UND-ARC/Nasa-SLI-2024/payload/pcb/SAIL_OBC/SAIL_OBC.png

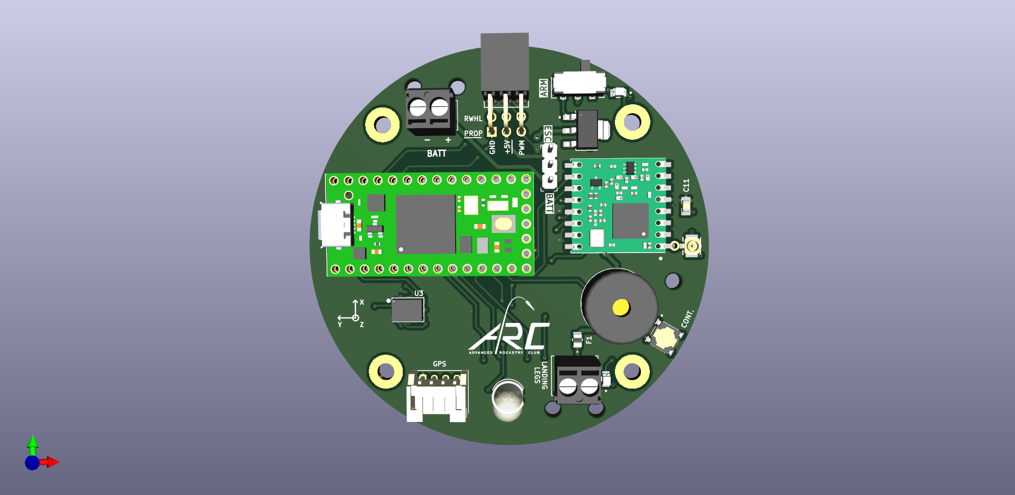
payload/pcb/SAIL_OBC/SAIL_OBC.png
