UND-ARC/Nasa-SLI-2024/payload/pcb/README.md

# SAIL PCBs

## Files included
- KiCad project file (.kicad_pro)
- KiCad schematic (.kicad_sch) 
- KiCad layout (.kicad_pcb)
- 3D view PNG
- Schematic PDF
- Layout PNG
- Interactive Bill of Materials (.html)

### Onboard Computer (OBC)
- Teensy Microcontroller 
- Sensors
- ESC connectors
- 4-pin JST connector to GPS
- 6-pin JST connector to PDB

### Power Distribution Board (PDB)
- Power input
- 5V and 3.3V Buck Regulators
- External Power Switchj
- Arming Switch
- Pyro Charges
	- Landing Legs
	- Wire Cutter 1
	- Wire Cutter 2
- VCC, 5V, 3.3V, and GND test points
- 6 pin JST connector to OBC
