UND-ARC/Nasa-SLI-2024/Data/Full Scale Launch 1/CD-update.png

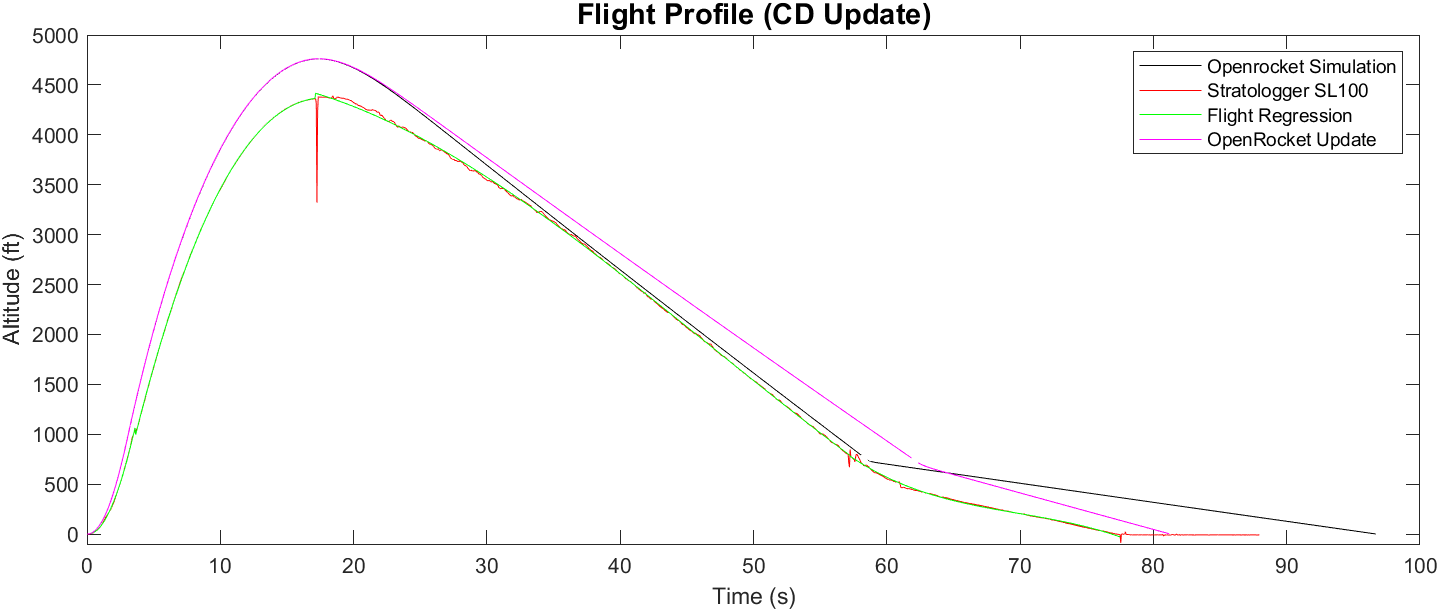
Data/Full Scale Launch 1/CD-update.png
