UND-ARC/Nasa-SLI-2024/Data/Full Scale Launch 1/openrocket-cd-update.png

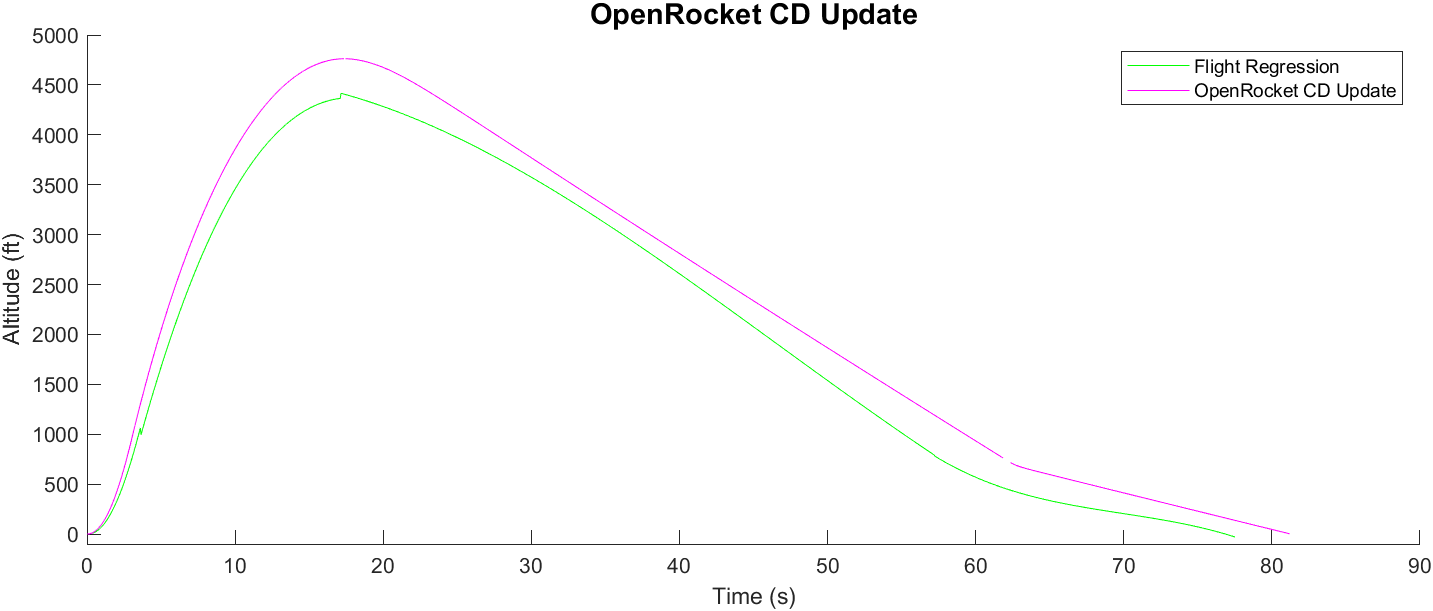
Data/Full Scale Launch 1/openrocket-cd-update.png
