UND-ARC/Nasa-SLI-2024/Data/Scale/NASA_Scale_Launch_2023.jpg

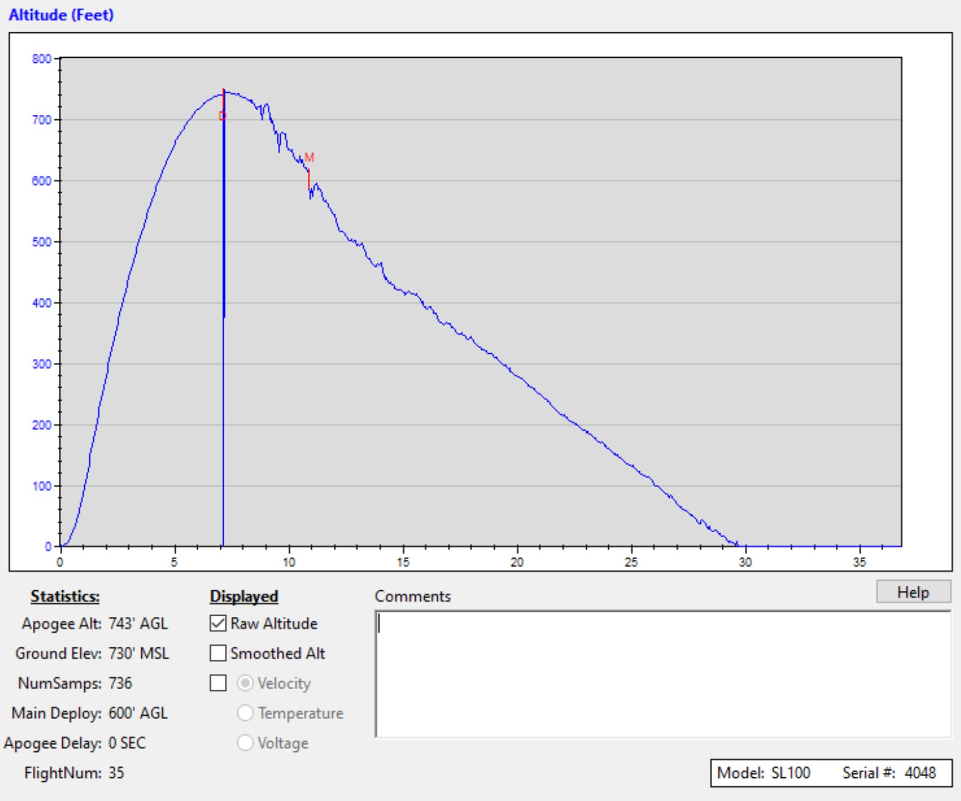
Data/Scale/NASA_Scale_Launch_2023.jpg
