UND-ARC/Nasa-SLI-2024/Data/Scale/Original_Openrocket_vs_Regression.png

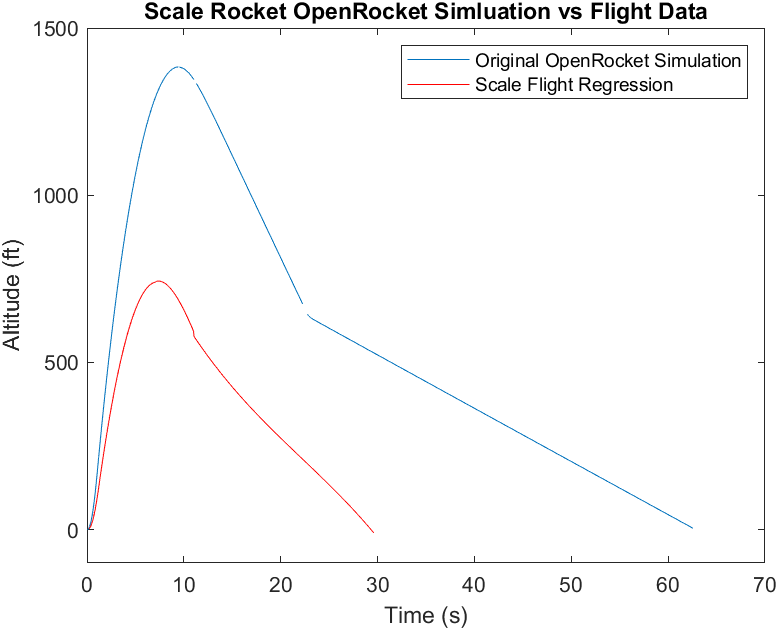
Data/Scale/Original_Openrocket_vs_Regression.png
