UND-ARC/Nasa-SLI-2024/Data/Scale/Regression_vs_New_openrocket.png

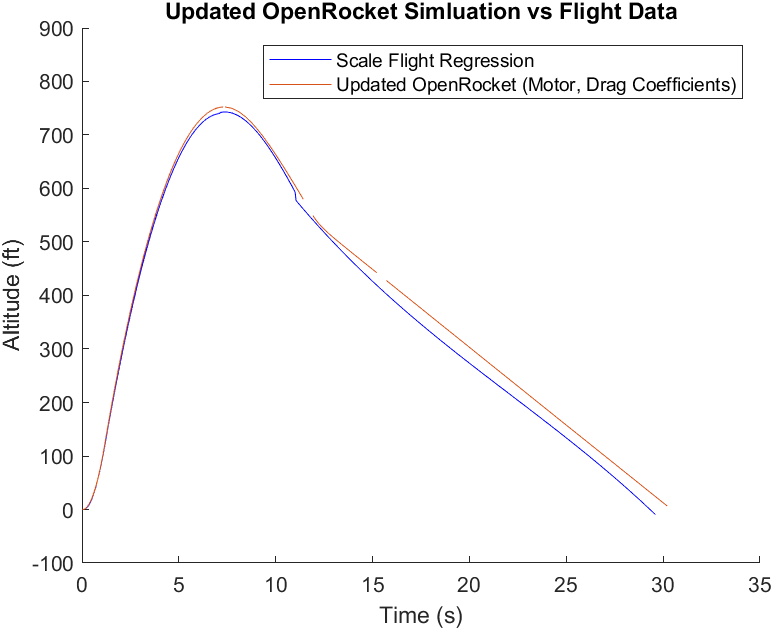
Data/Scale/Regression_vs_New_openrocket.png
