UND-ARC/Nasa-SLI-2024/Data/Scale/Scale_Flight_Raw_Data.png

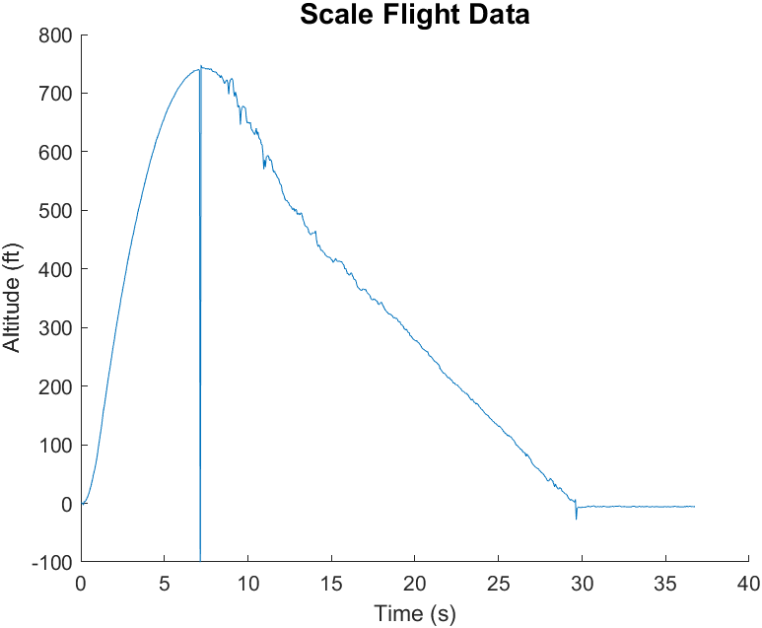
Data/Scale/Scale_Flight_Raw_Data.png
