UND-ARC/Nasa-SLI-2024/Data/Scale/Scale_Flight_Regression.png

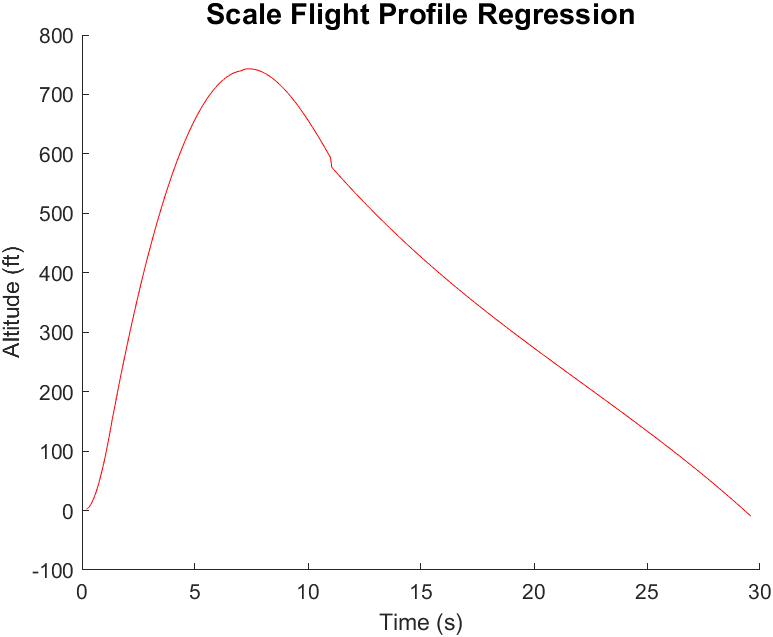
Data/Scale/Scale_Flight_Regression.png
