UND-ARC/Nasa-SLI-2024/Data/Scale/Scale_flight_vs_regression.png

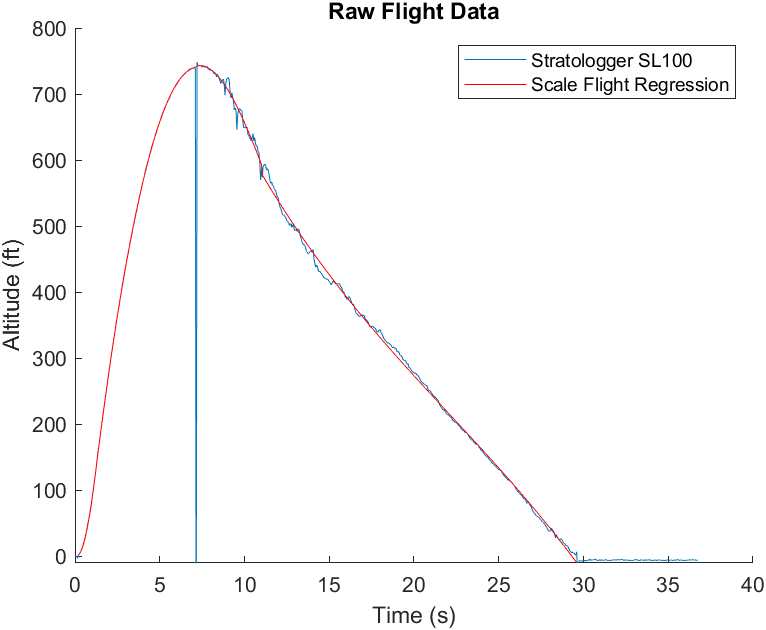
Data/Scale/Scale_flight_vs_regression.png
