UND-ARC/Nasa-SLI-2024/Data/Scale/Scale_openrocket_original.png

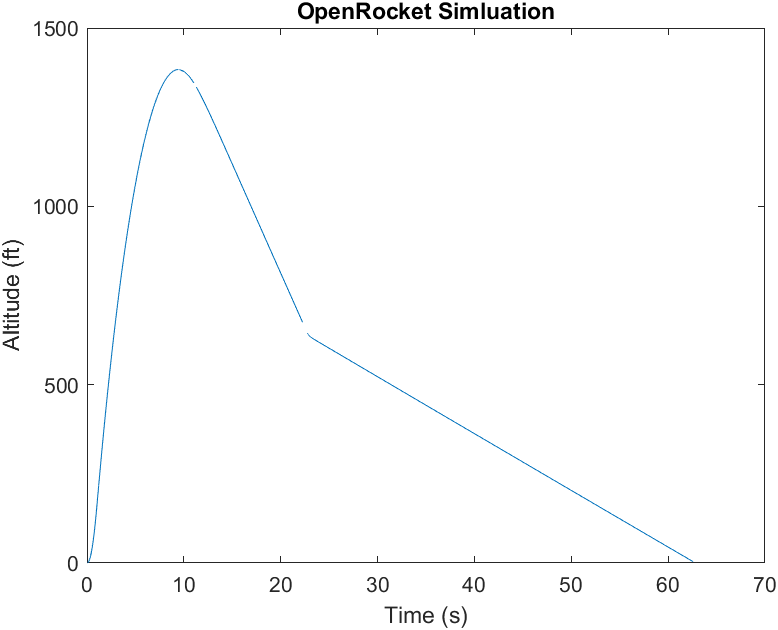
Data/Scale/Scale_openrocket_original.png
