UND-ARC/Nasa-SLI-2024/Data/Scale/Scale_Updated_OpenRocket_Plots.png

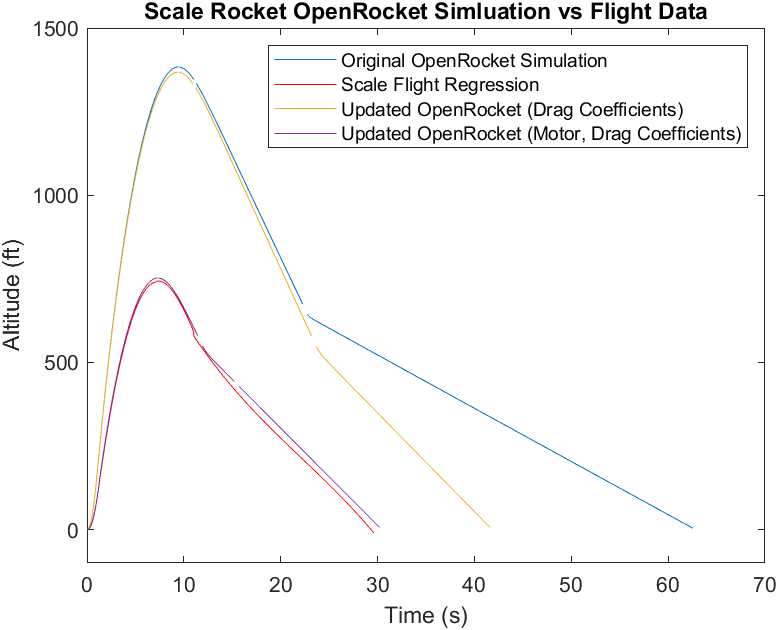
Data/Scale/Scale_Updated_OpenRocket_Plots.png
