UND-ARC/Nasa-SLI-2024/OpenRocket/L1420R-0wind.png

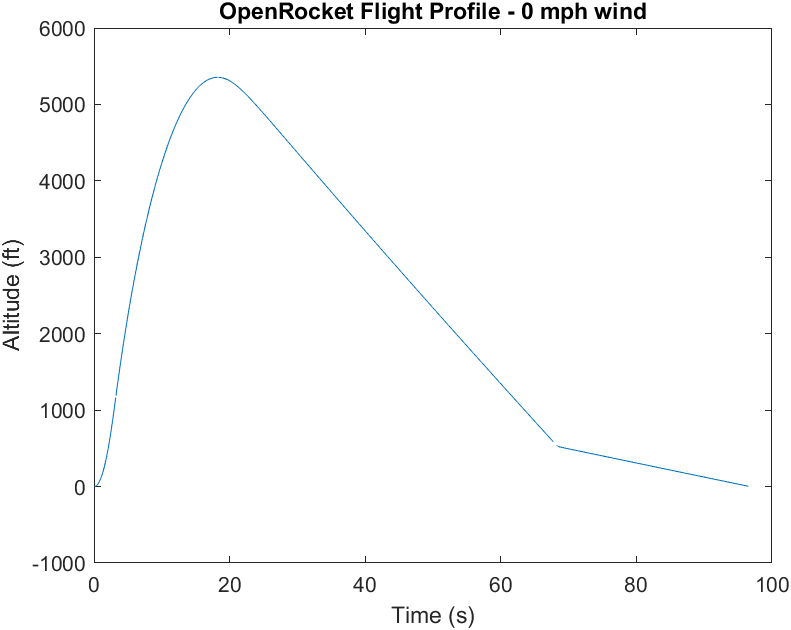
OpenRocket/L1420R-0wind.png
