UND-ARC/Nasa-SLI-2024/payload/src/Teensy_pinouts.png

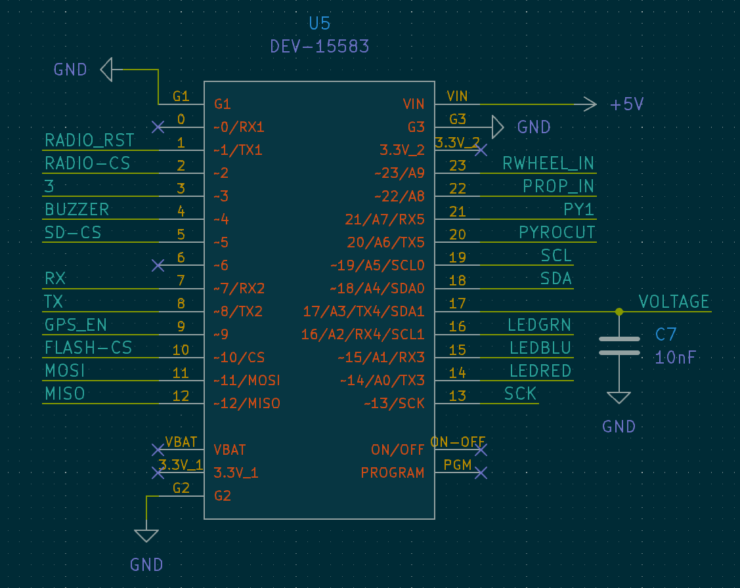
payload/src/Teensy_pinouts.png
