UND-ARC/Nasa-SLI-2024/OpenRocket/New NASA Fins.obj

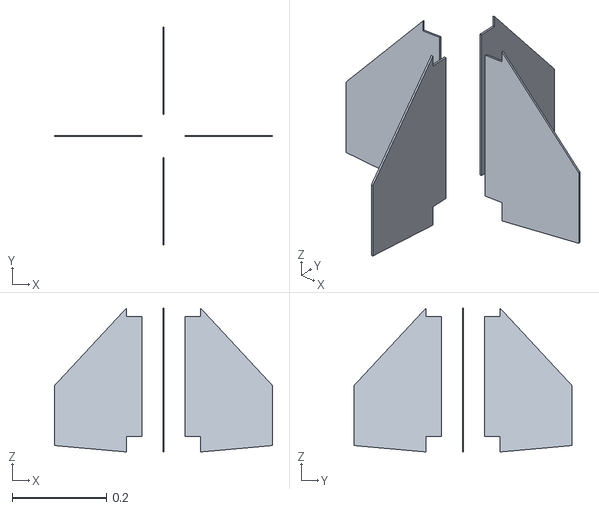
[picture p14: CAD file, 2024-03-03]
OpenRocket/New NASA Fins.obj
0.462 x 0.462 x 0.305
