UND-ARC/Nasa-SLI-2024/payload/pcb/old/SAIL_OBC/SAIL OBC 01-20-2024.pdf

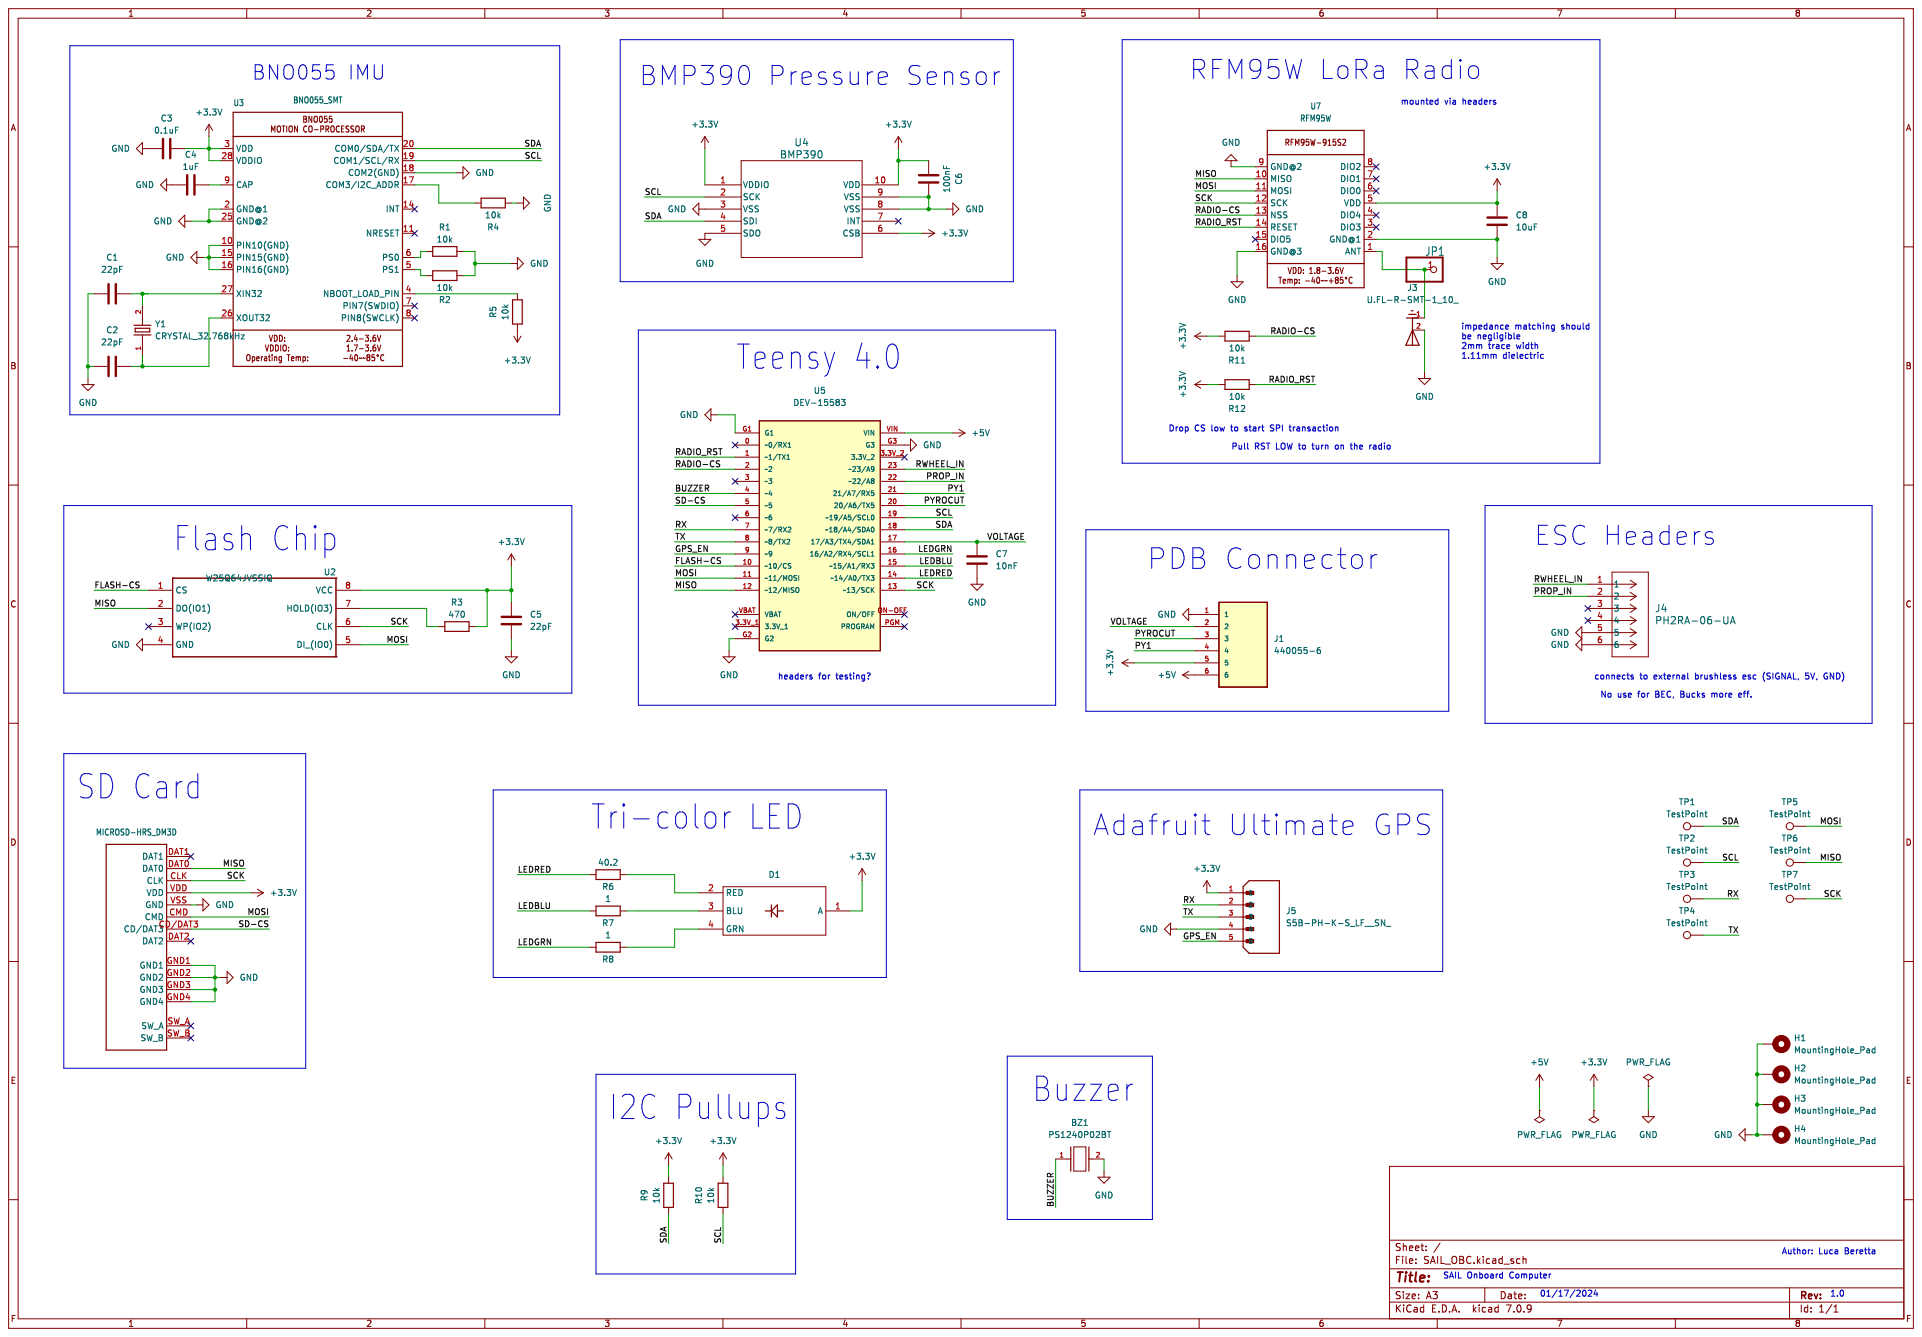
[picture p15: page 1]
