UND-ARC/Nasa-SLI-2024/payload/pcb/old/SAIL_PDB/SAIL_PDB 01-20-2024.pdf

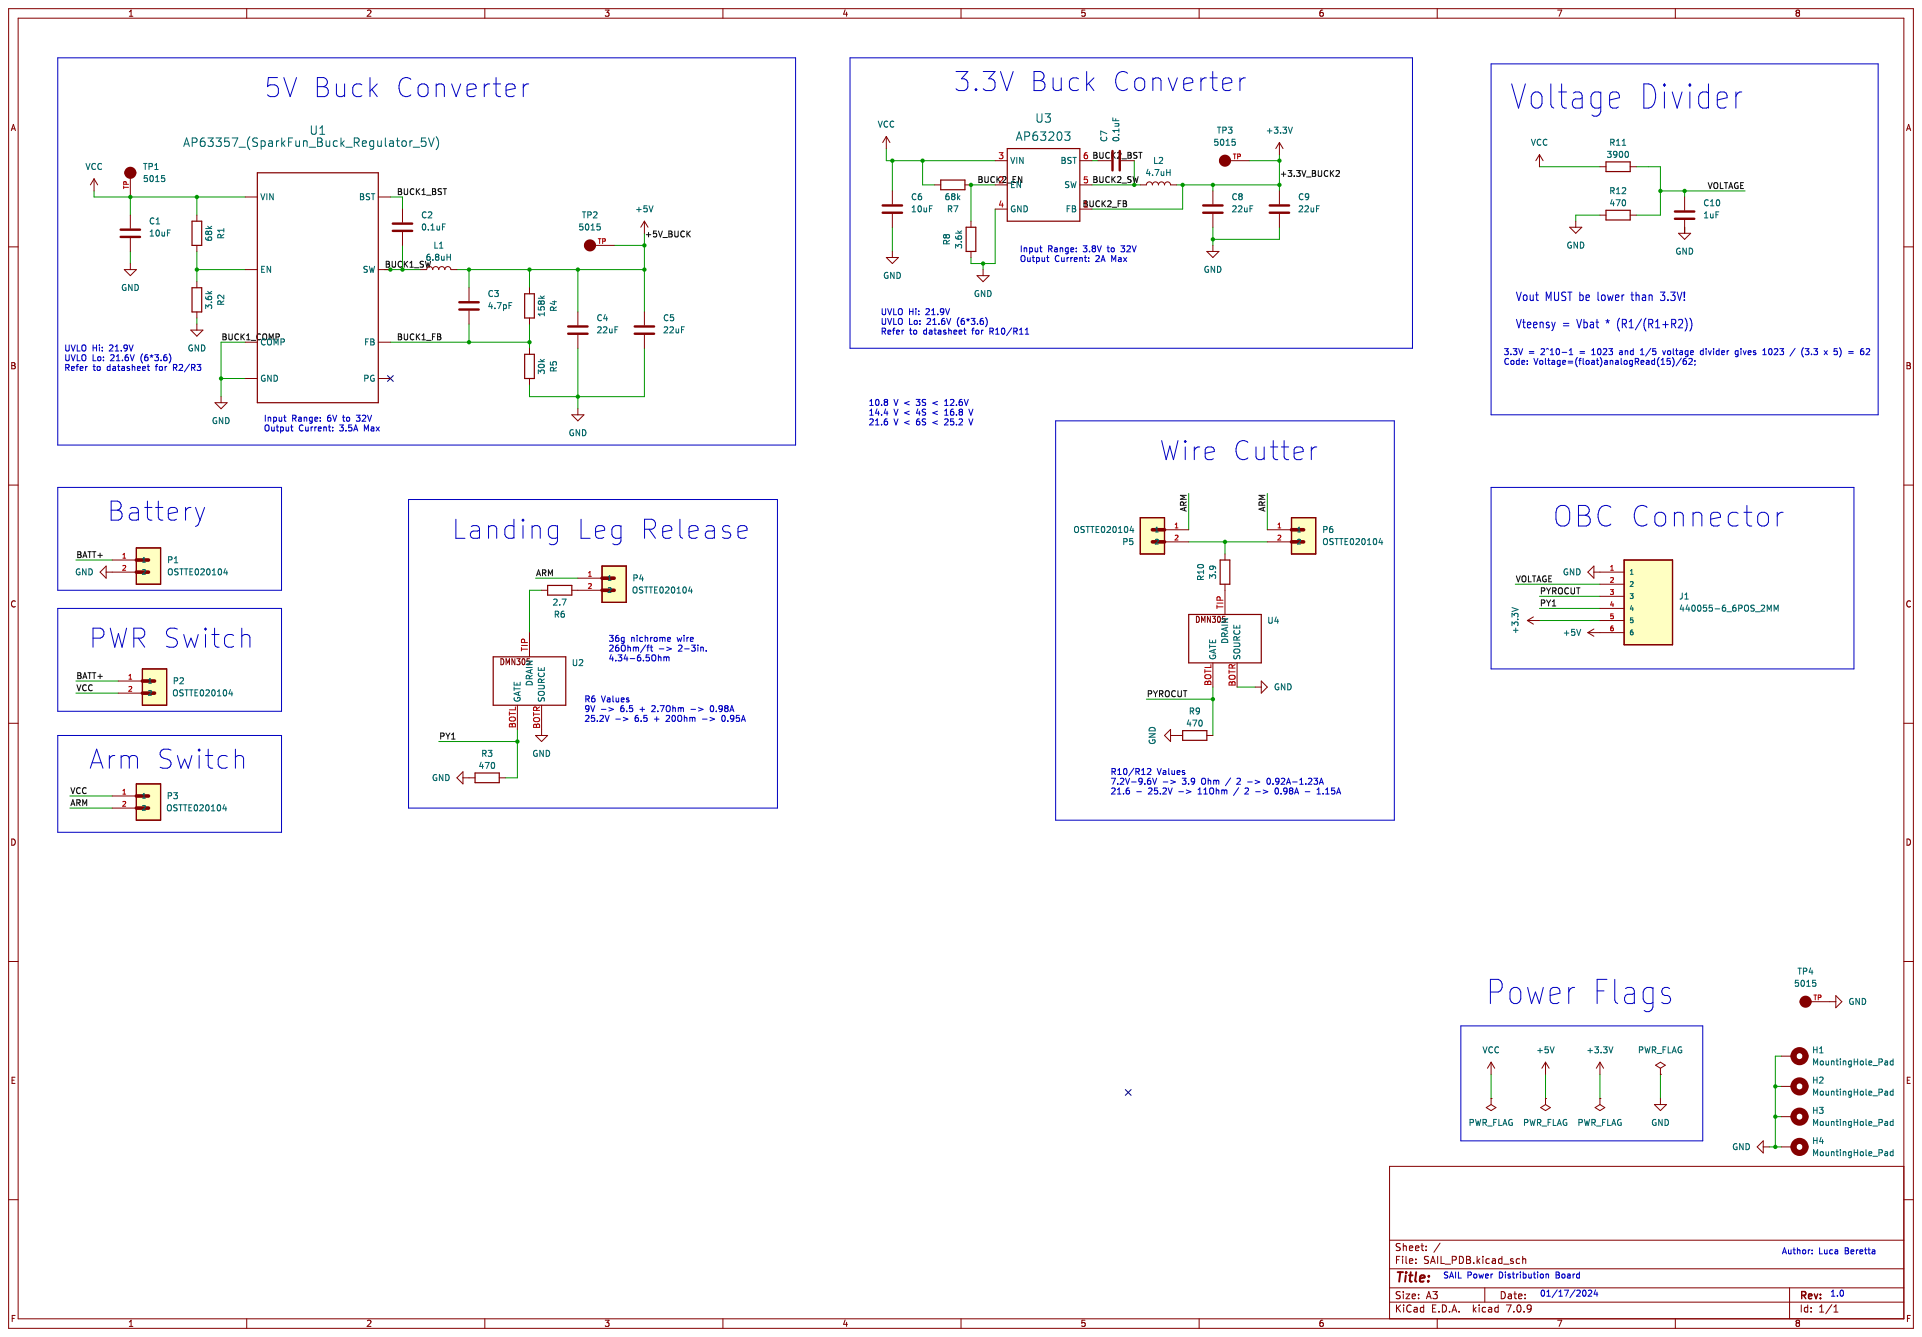
[picture p16: page 1]
