UND-ARC/Nasa-SLI-2024/payload/pcb/SAIL_Fairing/SAIL_Fairing.kicad_pcb

## KiCad design payload/pcb/SAIL_Fairing/SAIL_Fairing.kicad_pcb (2024-03-03)

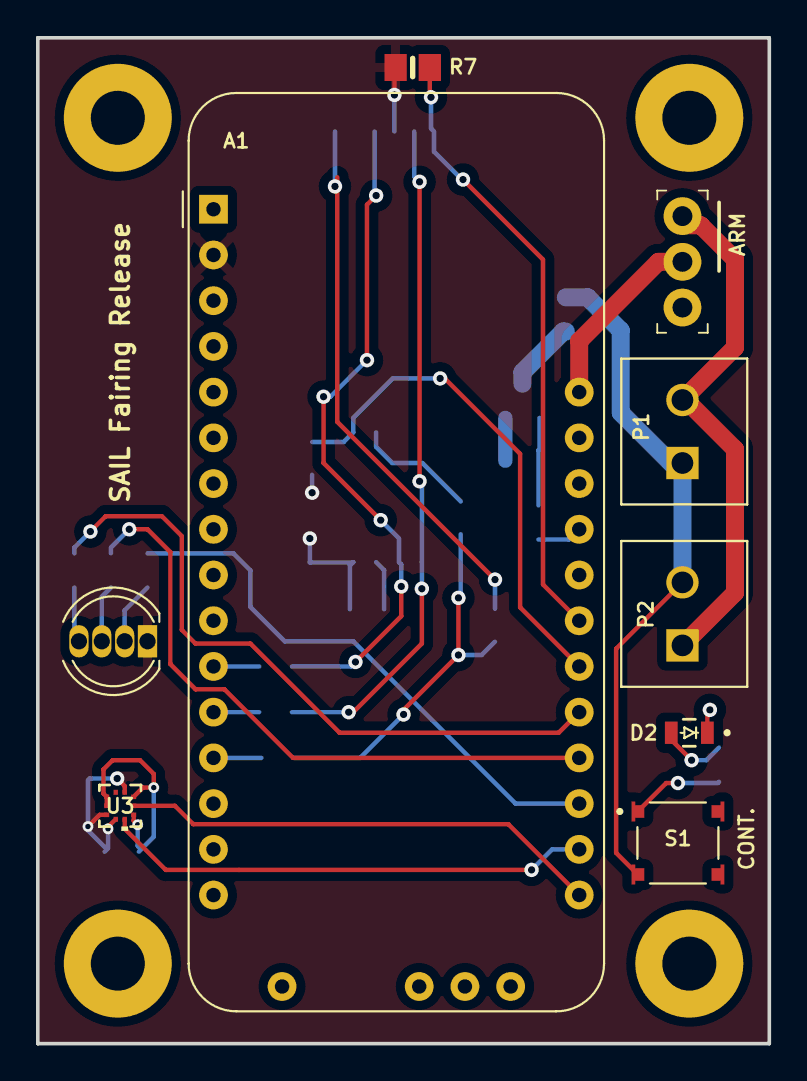
[picture p17: board SAIL_Fairing.kicad_pcb from above]

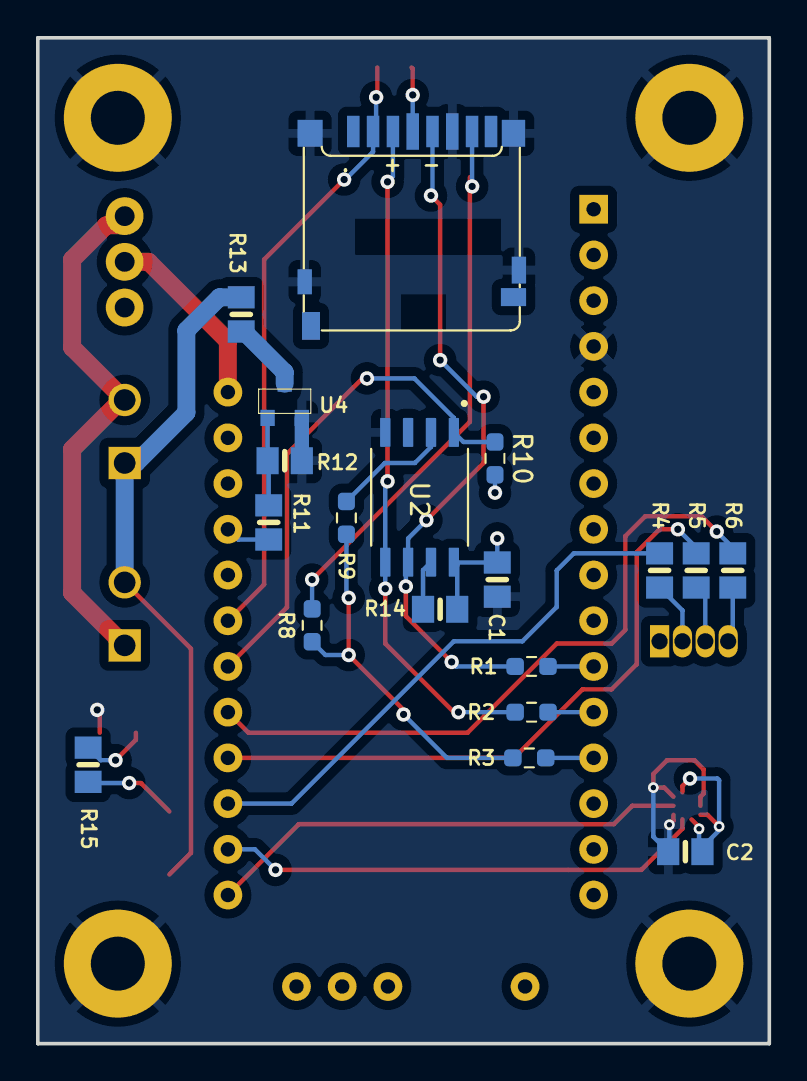
[picture p18: board SAIL_Fairing.kicad_pcb from below]

Board: 2 copper layers, 40.6 x 55.9 mm, 32 parts (19 on the bottom side), 29 nets.

Parts:
A1: Adafruit_Feather_M0_RFM9x_LoRa_Radio; Adafruit_Feather_M0_RFM
C1: 22pF; 0805-NO (Capacitor)
C2: 0.1uF; 0805-NO (Capacitor)
D1: TRI-COLOR LED; LED_D5.0mm-4_RGB
D2: LED; LED0805N_CML_(CMD17-21VRDTR8)
H1, H2, H3, H4: MountingHole_Pad; MountingHole_3mm_Pad
J1: PH1-03-UA; PinHeader_1x3_P2.54_Drill1.1mm
P1, P2: OSTTE020104; TERMBLOCK_OSTTE020104_3_5MM
R1, R2, R3, R8, R9: 10; R_0603_1608Metric_Pad0.98x0.95mm_HandSolder
R4: 75; 0805-NO-Resistor
R5, R6: 5; 0805-NO-Resistor
R7: 10k; 0805-NO-Resistor
R10: 10k; R_0603_1608Metric_Pad0.98x0.95mm_HandSolder
R11: 1k; 0805-NO-Resistor
R12, R14: 470; 0805-NO-Resistor
R13: 1; 0805-NO-Resistor
R15: 82; 0805-NO-Resistor
S1: TL3315NF100Q; SW_TL3315NF100Q
U1: MICROSD-HRS_DM3D
U2: W25Q64JVSSIQ
U3: BMP390; LGA10_BMP390_BOS
U4: DMN3051L-7

Connections:
+3.3V: A1.2 (3V3), C1.1, C2.1, D1.1 (A), R7.2, R10.2, R14.2, U1.VDD, U2.8 (VCC), U3.1 (VDDIO), U3.6 (CSB), U3.10 (VDD)
/ARM: J1.3, P1.2, P2.1
/CUT: A1.25 (D13), R11.1
/FLASH-CS: A1.22 (D10), R10.1, U2.1 (CS)
/LEDBLU: A1.20 (D6), R5.1
/LEDGRN: A1.21 (D9), R6.1
/LEDRED: A1.19 (D5), R4.1
/MISO: R3.2, R8.1, R9.2
/MOSI: R2.2, U1.CMD, U2.5 (DI_(IO0))
/SCK: R1.2, U1.CLK, U2.6 (CLK)
/SCL: A1.18 (SCL/D21), U3.2 (SCK)
/SD-CS: A1.23 (D11), R7.1, U1.CD/DAT3
/SDA: A1.17 (SDA/D20), U3.4 (SDI)
/VBAT: A1.28 (VBAT), J1.2
GND: A1.4 (GND), C1.2, C2.2, D2.1 (K), H1.1, H2.1, H3.1, H4.1, R12.1, U1.GND1, U1.GND2, U1.GND3, U1.GND4, U1.VSS (GND), U2.4 (GND), U3.3 (VSS), U3.5 (SDO), U3.8 (VSS), U3.9 (VSS), U4.BOTR (SOURCE)
unnamed: A1.13 (MISO/D22), R3.1
unnamed: A1.12 (MOSI/D23), R2.1
unnamed: A1.11 (SCK/D24), R1.1
unnamed: D1.3 (BLU), R5.2
unnamed: D1.4 (GRN), R6.2
unnamed: D1.2 (RED), R4.2
unnamed: D2.2 (A), R15.1
unnamed: P1.1, P2.2, R13.2, S1.3
unnamed: R8.2, U1.DAT0
unnamed: R15.2, S1.1
unnamed: R9.1, U2.2 (DO(IO1))
unnamed: R14.1, U2.7 (HOLD(IO3))
unnamed: R13.1, U4.TIP (DRAIN)
unnamed: R11.2, R12.2, U4.BOTL (GATE)
