UND-ARC/Nasa-SLI-2024/payload/pcb/SAIL_OBC/SAIL_OBC.kicad_pcb

## KiCad design payload/pcb/SAIL_OBC/SAIL_OBC.kicad_pcb (2024-03-03)

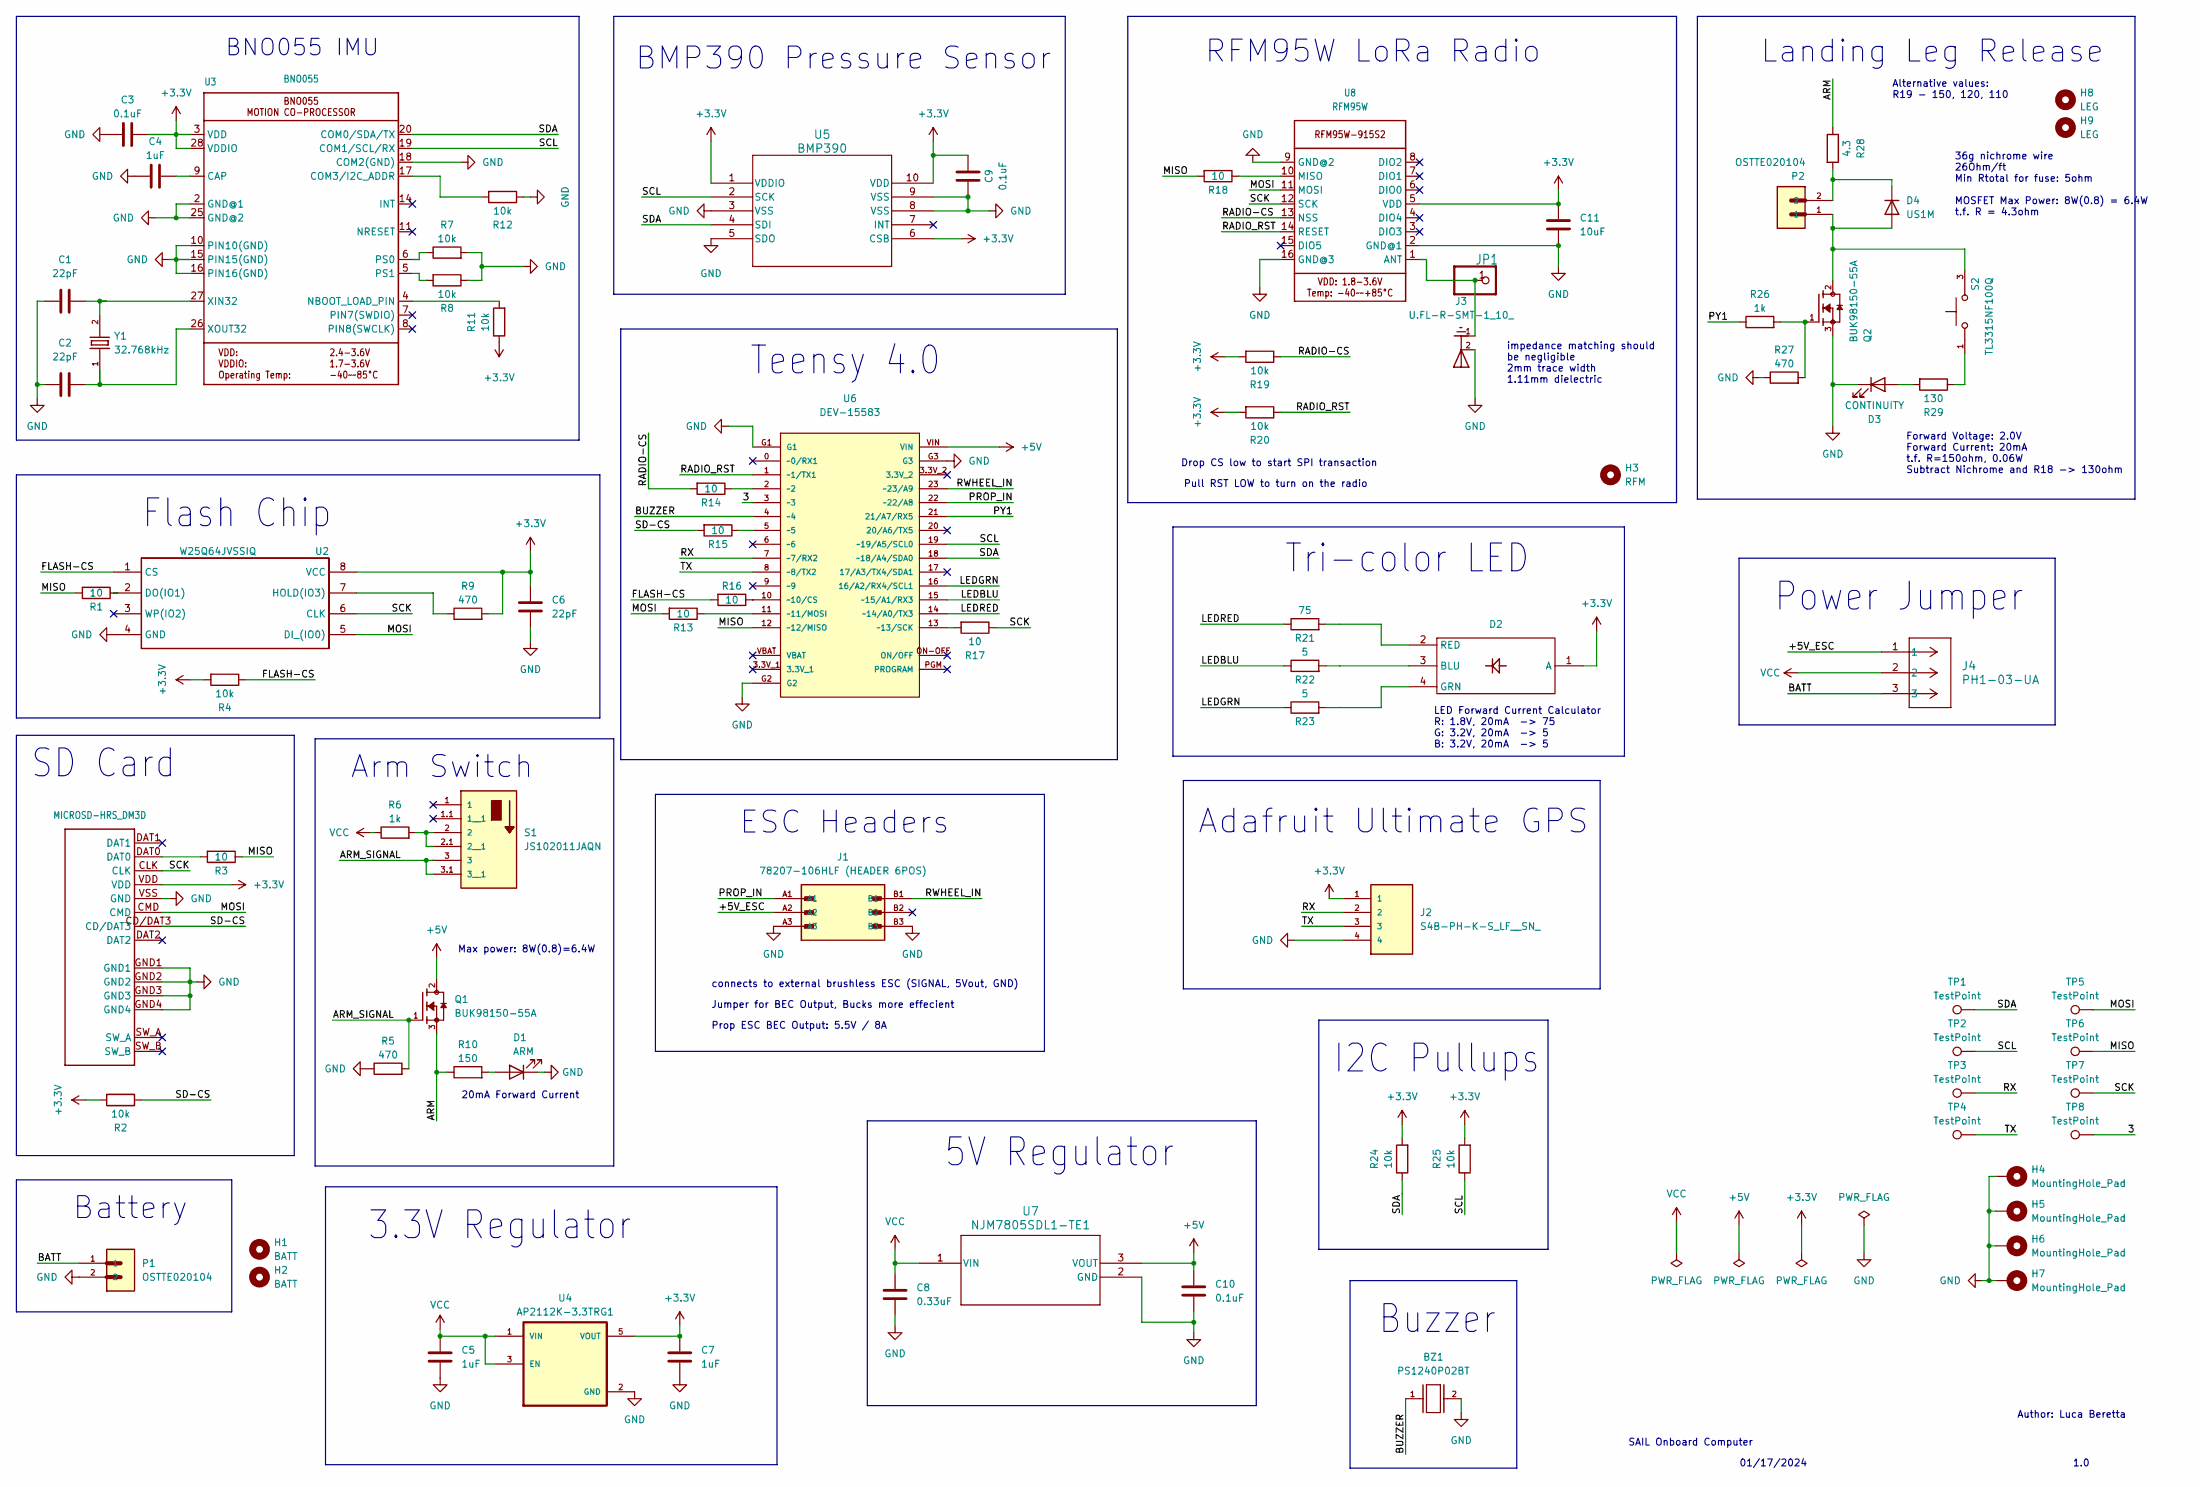
[picture p19: schematic SAIL_OBC.kicad_sch]

Parts:
BZ1: PS1240P02BT; BUZZER_XDCR_PS1240P02BT
C1, C2, C6: 22pF; 0805-NO (Capacitor)
C3, C9, C10: 0.1uF; 0805-NO (Capacitor)
C4, C5, C7: 1uF; 0805-NO (Capacitor)
C8: 0.33uF; 0805-NO (Capacitor)
C11: 10uF; 0805-NO (Capacitor)
D1: ARM; LED0805N_CML_(CMD17-21VRDTR8)
D2: TRI-COLOR LED; LED_D5.0mm-4_RGB
D3: CONTINUITY; LED0805N_CML_(CMD17-21VRDTR8)
D4: US1M; D_SMA
H1, H2: BATT; MountingHole_2.7mm_M2.5_ZIPTIE
H3: RFM; MountingHole_2.7mm_M2.5_ZIPTIE
H4, H5, H6, H7: MountingHole_Pad; MountingHole_3mm_Pad
H8, H9: LEG; MountingHole_2.7mm_M2.5_ZIPTIE
J1: 78207-106HLF (HEADER 6POS); AMPHENOL_78207-106HLF
J2: S4B-PH-K-S_LF__SN_; JST_S4B-PH-K-S_LF__SN_
J3: U.FL-R-SMT-1_10_; CONN1_UFL-R_HIR
J4: PH1-03-UA; PinHeader_1x3_P2.54_Drill1.1mm
JP1: HEADER-1X1ROUND; 1X01_ROUND
P1, P2: OSTTE020104; TERMBLOCK_OSTTE020104_3_5MM
Q1, Q2: BUK98150-55A; BUK98150-55ACUF
R1, R3, R13, R14, R15, R16, R17, R18: 10; R_0603_1608Metric_Pad0.98x0.95mm_HandSolder
R2, R7, R8, R11, R12, R19, R20, R24, R25: 10k; 0805-NO-Resistor
R4: 10k; R_0603_1608Metric_Pad0.98x0.95mm_HandSolder
R5, R9, R27: 470; 0805-NO-Resistor
R6, R26: 1k; 0805-NO-Resistor
R10: 150; 0805-NO-Resistor
R21: 75; 0805-NO-Resistor
R22, R23: 5; 0805-NO-Resistor
R28: 4.3; RESC6331X65N
R29: 130; 0805-NO-Resistor
S1: JS102011JAQN; SW_JS102011JAQN
S2: TL3315NF100Q; SW_TL3315NF100Q
TP1, TP2, TP3, TP4, TP5, TP6, TP7, TP8: TestPoint; TestPoint_Pad_2.0x2.0mm
U1: MICROSD-HRS_DM3D
U2: W25Q64JVSSIQ
U3: BNO055; BNO055_SMT
U4: AP2112K-3.3TRG1; SOT95P285X140-5N
U5: BMP390; LGA10_BMP390_BOS
U6: DEV-15583; MODULE_DEV-15583
U7: NJM7805SDL1-TE1; TO-252-3-L1_NMD
U8: RFM95W; RFMHCW_SMT
Y1: 32.768kHz; CRYSTAL_ECS-.327-12.5-34B-TR

Connections:
+3.3V: C3.2, C6.1, C7.1, C9.2, C11.2, D2.1 (A), J2.1, R2.2, R4.2, R9.2, R11.1, R19.2, R20.2, R24.2, R25.2, U1.VDD, U2.8 (VCC), U3.3 (VDD), U3.28 (VDDIO), U4.5 (VOUT), U5.1 (VDDIO), U5.6 (CSB), U5.10 (VDD), U8.5 (VDD)
+5V: C10.2, Q1.2, U6.VIN, U7.3 (VOUT)
/3: TP8.1, U6.3 (~3)
/+5V_ESC: J1.A2, J4.1
/ARM: Q1.3, R10.1, R28.1
/ARM_SIGNAL: Q1.1, R5.2, S1.3, S1.3.1 (3__1)
/BATT: J4.3, P1.1
/BUZZER: BZ1.1, U6.4 (~4)
/FLASH-CS: R4.1, R16.2, U2.1 (CS)
/LEDBLU: R22.1, U6.15 (~15/A1/RX3)
/LEDGRN: R23.1, U6.16 (16/A2/RX4/SCL1)
/LEDRED: R21.1, U6.14 (~14/A0/TX3)
/MISO: R1.2, R3.1, R18.2, TP6.1, U6.12 (~12/MISO)
/MOSI: R13.2, TP5.1, U1.CMD, U2.5 (DI_(IO0)), U8.11 (MOSI)
/PROP_IN: J1.A1, U6.22 (~22/A8)
/PY1: R26.1, U6.21 (21/A7/RX5)
/RADIO-CS: R14.2, R19.1, U8.13 (NSS)
/RADIO_RST: R20.1, U6.1 (~1/TX1), U8.14 (RESET)
/RWHEEL_IN: J1.B1, U6.23 (~23/A9)
/RX: J2.2, TP3.1, U6.7 (~7/RX2)
/SCK: R17.1, TP7.1, U1.CLK, U2.6 (CLK), U8.12 (SCK)
/SCL: R25.1, TP2.1, U3.19 (COM1/SCL/RX), U5.2 (SCK), U6.19 (~19/A5/SCL0)
/SD-CS: R2.1, R15.2, U1.CD/DAT3
/SDA: R24.1, TP1.1, U3.20 (COM0/SDA/TX), U5.4 (SDI), U6.18 (~18/A4/SDA0)
/TX: J2.3, TP4.1, U6.8 (~8/TX2)
GND: BZ1.2, C1.1, C2.1, C3.1, C4.1, C5.2, C6.2, C7.2, C8.1, C9.1, C10.1, C11.1, D1.1 (K), D3.1 (K), H4.1, H5.1, H6.1, H7.1, J1.A3, J1.B3, J2.4, J3.2, P1.2, Q2.3, R5.1, R7.2, R8.1, R12.1, R27.1, U1.GND1, U1.GND2, U1.GND3, U1.GND4, U1.VSS (GND), U2.4 (GND), U3.2 (GND@1), U3.10 (PIN10(GND)), U3.15 (PIN15(GND)), U3.16 (PIN16(GND)), U3.18 (COM2(GND)), U3.25 (GND@2), U4.2 (GND), U5.3 (VSS), U5.5 (SDO), U5.8 (VSS), U5.9 (VSS), U6.G1, U6.G2, U6.G3, U7.2 (GND), U8.2 (GND@1), U8.9 (GND@2), U8.16 (GND@3)
unnamed: D1.2 (A), R10.2
unnamed: D2.3 (BLU), R22.2
unnamed: D2.4 (GRN), R23.2
unnamed: D2.2 (RED), R21.2
unnamed: D3.2 (A), R29.2
unnamed: D4.2 (A), P2.1, Q2.2, S2.3
unnamed: D4.1 (K), P2.2, R28.2
unnamed: Q2.1, R26.2, R27.2
unnamed: R3.2, U1.DAT0
unnamed: R29.1, S2.1
unnamed: R6.2, S1.2, S1.2.1 (2__1)
unnamed: R1.1, U2.2 (DO(IO1))
unnamed: R9.1, U2.7 (HOLD(IO3))
unnamed: C4.2, U3.9 (CAP)
unnamed: R12.2, U3.17 (COM3/I2C_ADDR)
unnamed: R11.2, U3.4 (NBOOT_LOAD_PIN)
unnamed: R7.1, U3.6 (PS0)
unnamed: R8.2, U3.5 (PS1)
unnamed: C1.2, U3.27 (XIN32), Y1.2
unnamed: C2.2, U3.26 (XOUT32), Y1.1
unnamed: R14.1, U6.2 (~2)
unnamed: R15.1, U6.5 (~5)
unnamed: R16.1, U6.10 (~10/CS)
unnamed: R13.1, U6.11 (~11/MOSI)
unnamed: R17.2, U6.13 (~13/SCK)
unnamed: J3.1, JP1.1, U8.1 (ANT)
unnamed: R18.1, U8.10 (MISO)
VCC: C5.1, C8.2, J4.2, R6.1, U4.1 (VIN), U4.3 (EN), U7.1 (VIN)

Notes on the sheet:
3.3V Regulator
Alternative values: R19 - 150, 120, 110
Prop ESC BEC Output: 5.5V / 8A
Max power: 8W(0.8)=6.4W
36g nichrome wire 26Ohm/ft Min Rtotal for fuse: 5ohm MOSFET Max Power: 8W(0.8) = 6.4W t.f. R = 4.3ohm
Flash Chip
BMP390 Pressure Sensor
Battery
Author: Luca Beretta
Buzzer
connects to external brushless ESC (SIGNAL, 5Vout, GND)
SD Card
5V Regulator
LED Forward Current Calculator R: 1.8V, 20mA -> 75 G: 3.2V, 20mA -> 5 B: 3.2V, 20mA -> 5
01/17/2024
Teensy 4.0
Drop CS low to start SPI transaction
Forward Voltage: 2.0V Forward Current: 20mA t.f. R=150ohm, 0.06W Subtract Nichrome and R18 -> 130ohm
Power Jumper
ESC Headers
1.0
BNO055 IMU
SAIL Onboard Computer
RFM95W LoRa Radio
impedance matching should be negligible 2mm trace width 1.11mm dielectric
Arm Switch
Jumper for BEC Output, Bucks more effecient
Pull RST LOW to turn on the radio
Adafruit Ultimate GPS
Landing Leg Release
20mA Forward Current
I2C Pullups
Tri-color LED

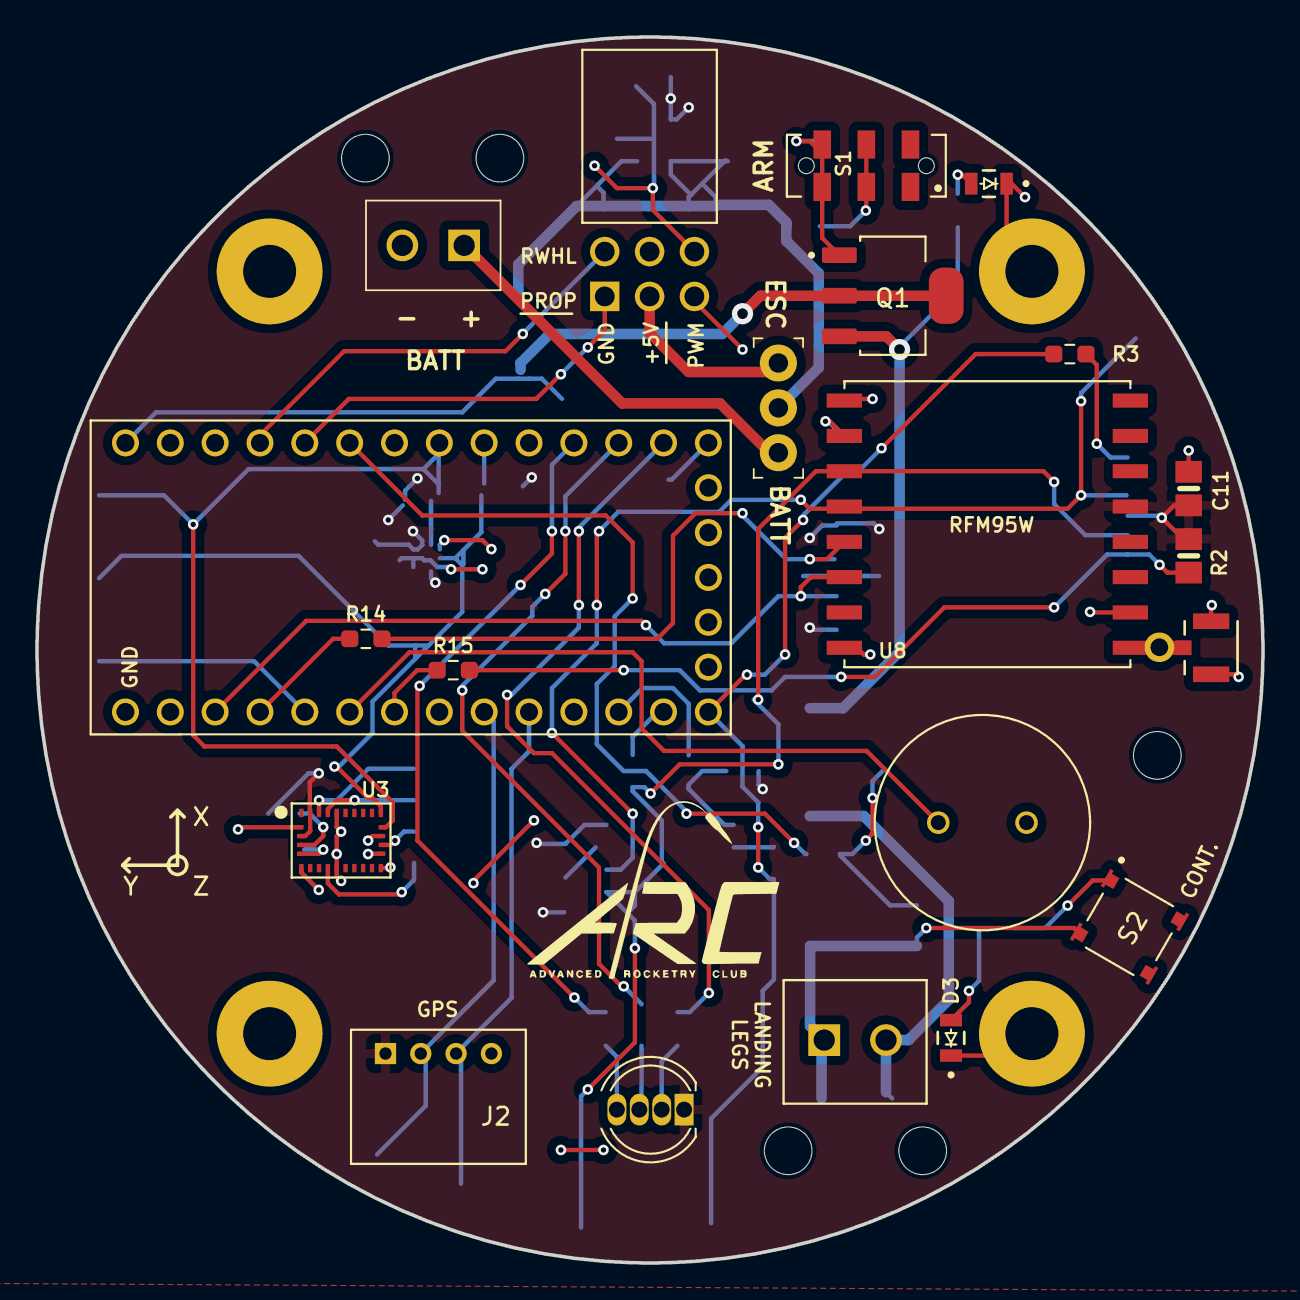
[picture p20: board SAIL_OBC.kicad_pcb from above]

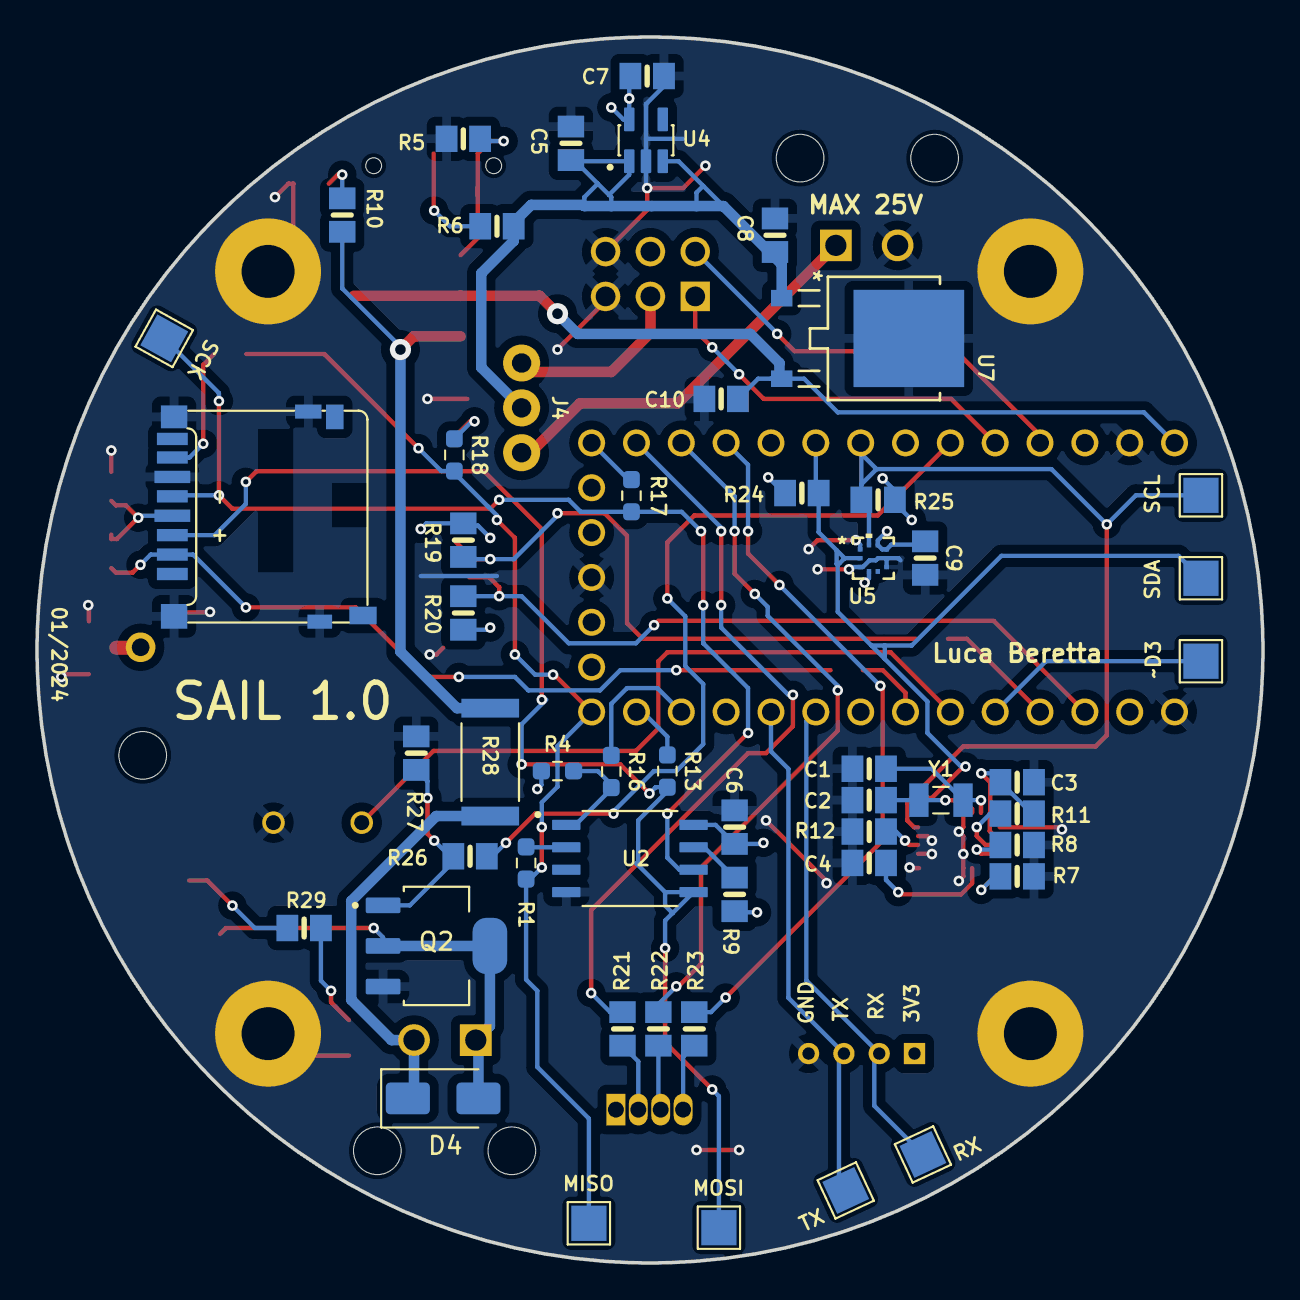
[picture p21: board SAIL_OBC.kicad_pcb from below]

Board: 2 copper layers, 69.4 x 69.4 mm, 82 parts (51 on the bottom side), 54 nets.
