UND-ARC/Nasa-SLI-2024/(commit log)

2023-09-11 NEW AND BETTER
    [L1420R-P - 0 wind speed.csv]
2023-12-19 Add files via upload
    Added SAIL payload files
    [SAIL_1_0.kicad_pcb, SAIL_1_0.kicad_sch]
2023-12-22 Scale launch data added
    [Scale_Stratologger.csv]
2023-12-23 Update BMP390_I2C.ino
    Commented out SPI
2023-12-23 Add files via upload
    BNO055 sensorapi example modified for Teensy.
    Note: comment out
    /* Reset */
    write8(BNO055_SYS_TRIGGER_ADDR, 0x20); in .cpp library
    [BNO055_sensorapi_Teensy.ino]
2023-12-23 Add files via upload
    BNO055 sensorapi exaple modified for SAIL program. (For testing individual sensor)
    I believe this uses sensor fusion so will need raw data example
2023-12-28 Add files via upload
    Tested with Serial Monitor and breakout boards
    RFM95 needs tuning
2024-01-04 Update and rename payload/test/BMP390_I2C.ino to payload/test/sensors/BMP390_I2C.ino
2024-01-04 Update and rename payload/test/BNO055_sensorapi_SAIL.ino to payload/test/sensors/BNO055_sensorapi_SAIL.ino
2024-01-04 Update and rename payload/test/BNO055_sensorapi_Teensy.ino to payload/test/sensors/BNO055_sensorapi_Teensy.ino
2024-01-04 Reorganiztion
    Reorganized files, added psuedocode for propeller and reaction wheel
2024-01-07 Scale flight analysis
    [Scale_Original_Openrocket.csv, Scale_Updated_Analysis.csv, Scale_Updated_Analysis_Different_Motor.csv]
2024-01-07 Updated openrocket
    [Scale_Updated_Analysis.csv, Scale_Updated_Analysis_Different_Motor.csv]
2024-01-07 Added google sheet of analysis (converted to xlsx)
    [NASA Scale Flight Analysis 2024(From Google Sheets).xlsx]
2024-01-08 Updated upper body tube size
2024-01-08 updated the stuff
    [L1420R-P-0-wind-V2.csv, L1420R-P-10-wind-V2.csv, L1420R-P-15-wind-V2.csv, L1420R-P-20-wind-V2.csv, L1420R-P-5-wind-V2.csv]
2024-01-17 PCB update
    Updated pcb files, schematic pdf, layout png, empty footprints file
    [SAIL_1_0.kicad_pcb, SAIL_1_0.kicad_sch, SAIL_OBC.kicad_pcb, SAIL_OBC.kicad_sch, SAIL_PDB.kicad_pcb, SAIL_PDB.kicad_sch]
2024-01-18 Added interactive BOM
    .html files
2024-01-20 Updated PCBs
    [SAIL_OBC (new)-DESKTOP-90QTPOV.kicad_sch, SAIL_OBC.kicad_pcb, SAIL_OBC.kicad_sch, SAIL_PDB.kicad_pcb, SAIL_PDB.kicad_sch]
2024-01-21 Updated pcb files
    [SAIL_OBC (new)-DESKTOP-90QTPOV.kicad_sch, SAIL_PDB.kicad_pcb, SAIL_PDB.kicad_sch]
2024-01-21 Updated PCBs
    im dumb
    [SAIL_PDB.kicad_pcb, SAIL_PDB.kicad_sch]
2024-01-29 FSM update
    [SAIL_OBC.kicad_pcb, SAIL_OBC.kicad_sch]
2024-01-30 Update GS and Prop
2024-02-03 Added MATLAB models
    Control System and BLDC Speed Control (to implement in Control System)
2024-02-28 ESC test
2024-02-28 120A ESC test works
2024-03-03 New fin design to accomodate available materials
    [New NASA Fins.obj]
2024-03-04 Flight data from full scale launch
    [Primary Data.csv, Secondary Data.csv]
2024-03-04 Openrocket update and full scale flight analysis
    [20wind_openrocket-update.csv, 20wind_openrocket.csv, Primary_Data.csv]
2024-03-18 DUAL ESC WORKING
2024-03-19 Create Dual_ESC_test_working.ino
    took out high throttle, still works
